BDabek1/sMouthguard/fab/sMouthguard01_BOM_JLC.csv

Comment | Designator | Footprint | LCSC Part #
100nF 6.3V X5R | C2,C3,C5,C6,C9,C11,C12,C15 | 0201 | C160831
2.2uF 6.3V X5R CL03A225MQ3CRNC | C8,C18 | 0201 | C77762
4.7uF 6.3V X5R GRM035R60J475ME15D | C10,C13 | 0201
1uF 10V X5R | C17,C23,C24 | 0201 | C76935
10pF 50V C0G | C7,C19 | 0201 | C76921
2.2uF 6.3V X5R | C4 | 0402 | C12530
1uF 25V X5R | C16 | 0402 | C52923
1pF 50V C0G +/-0.1pF | C26 | 0402 | C76898
68nF 50V X7R | C14 | 0603 | C31658
10uH MLZ1608N100LT000 | L1 | 0603 | C194437
3.9nH LQG15HS3N9S02D | L3 | 0402 | C77109
2.7nH LQG15HS2N7S02D | L4 | 0402 | C77108
10k 1% | R2 | 0402 | C25744
2.2k 1% | R5,R7,R8 | 0402 | C25879
BLM18HE152SN1D | FL1 | 0603 | C82155
CC2640R2FRSMR | U4 | VQFN-32_4x4mm | C133236
LTC4124EV#TRPBF | U2 | LQFN-12_2x2mm | C687345
TPS7A0233PDQNR | U5 | X2SON-4_1x1mm | C2860046
LSM6DSV320XTR | U1 | LGA-14_2.5x3mm
2450BM14G0011T | Z2 | 0603-6pad | C2917723
2450AT18A100E (=2450AT18A0100001E) | E2 | 3216 | C89334
FC-135R 32.7680KA-AG0 | Y1 | 3215
TSX-3225 24.0000MF15X-AC3 | Y2 | 3225-4pad
