BDabek1/sMouthguard/hardware/sMouthguard01.kicad_pcb

## KiCad design hardware/sMouthguard01.kicad_pcb (2026-11-03)

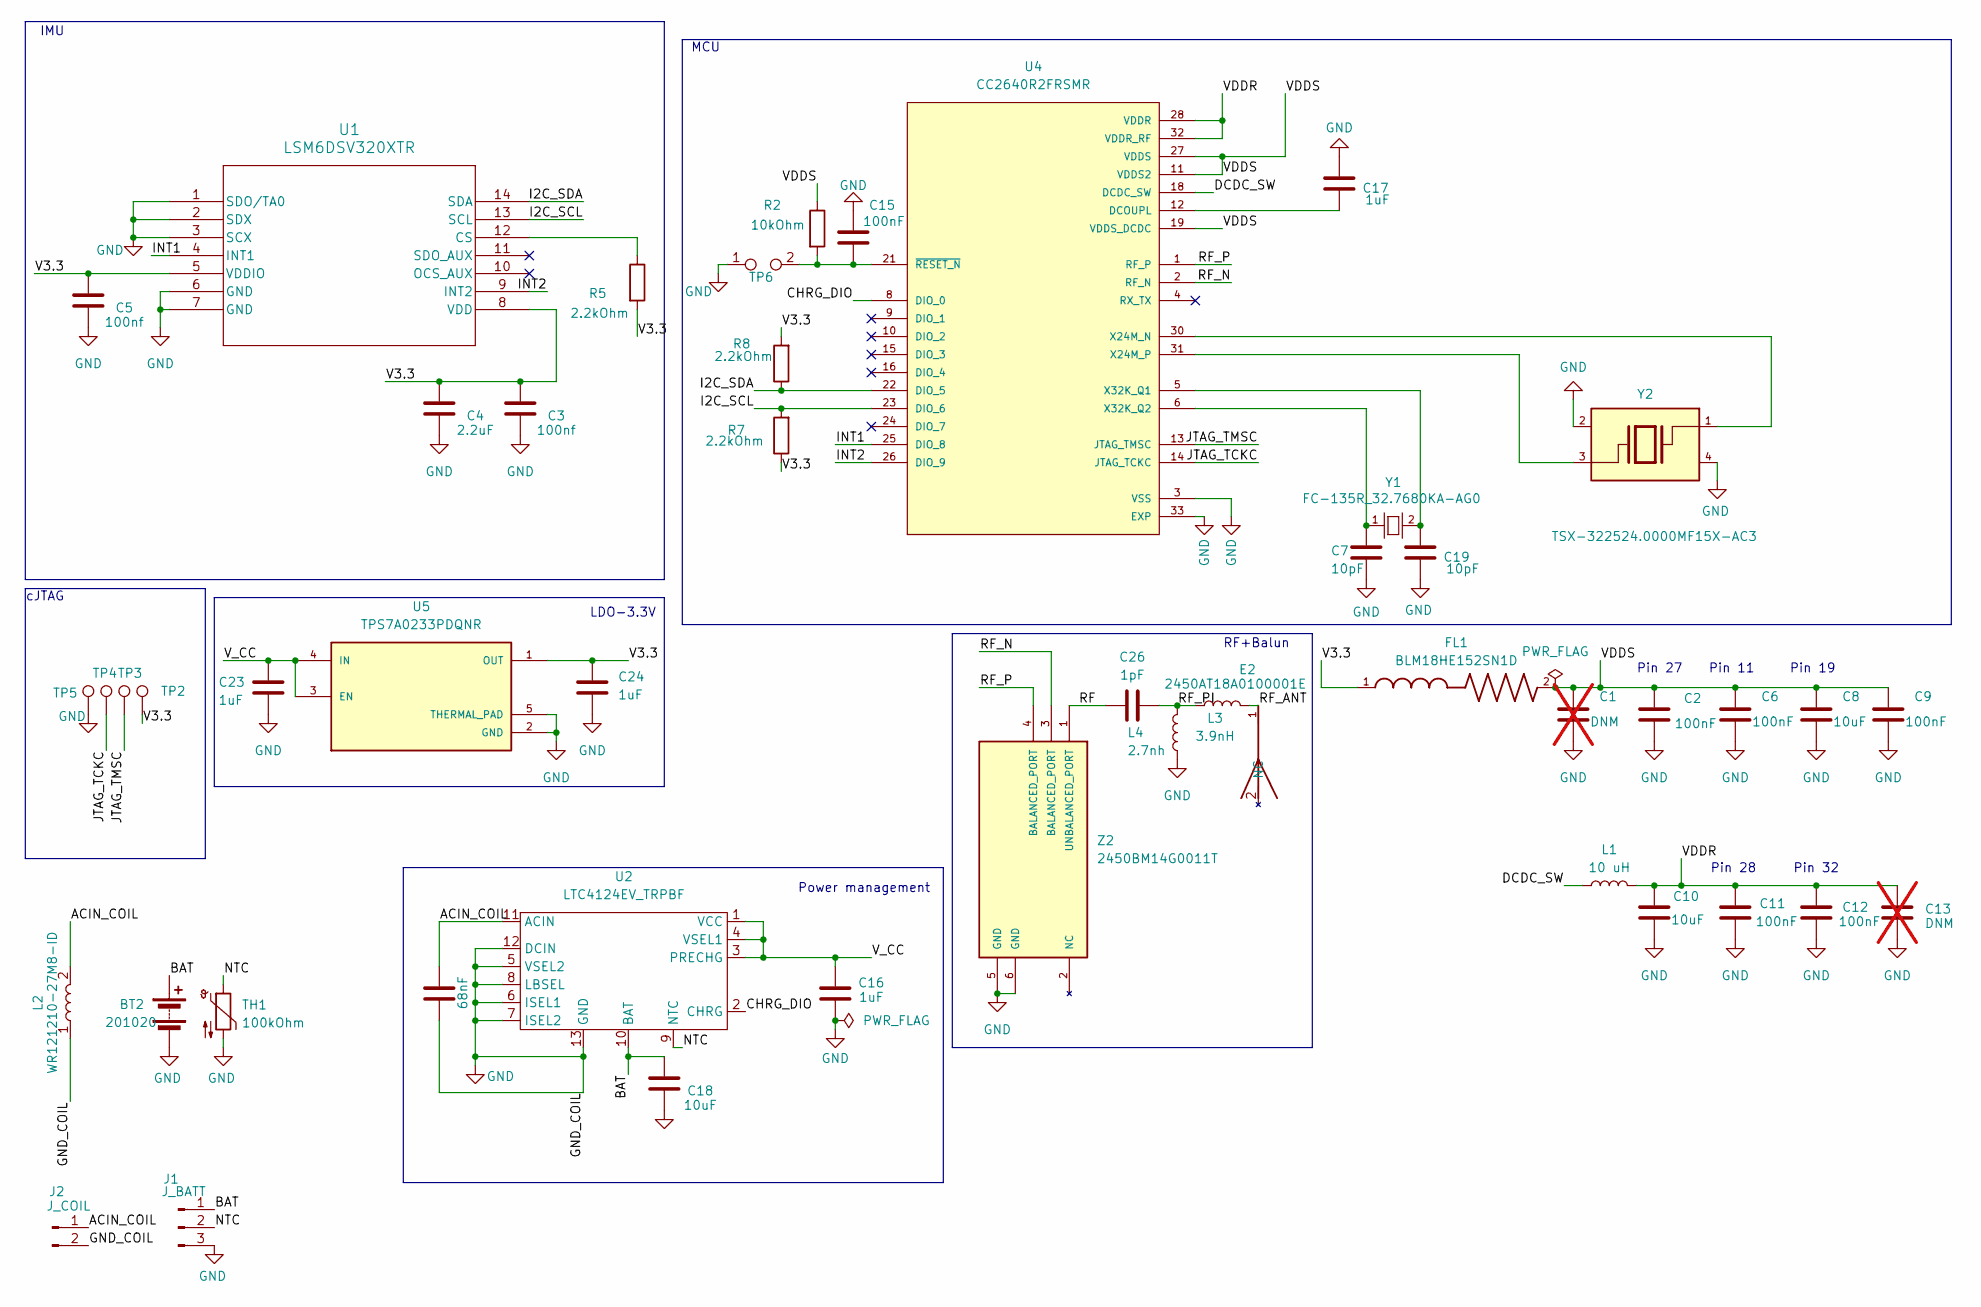
[picture p1: schematic sMouthguard01.kicad_sch, sMouthguard BLE IMU Sensing Device]

Parts:
BT2: 201020
C1, C13: DNM; C_0201_0603Metric; not fitted
C2, C6, C9, C11, C12, C15: 100nF; C_0201_0603Metric
C3, C5: 100nf; C_0201_0603Metric
C4: 2.2uF; C_0402_1005Metric
C7, C19: 10pF; C_0201_0603Metric
C8, C10, C18: 10uF; C_0201_0603Metric
C14: 68nF; C_0603_1608Metric
C16: 1uF; C_0402_1005Metric
C17, C23, C24: 1uF; C_0201_0603Metric
C26: 1pF; C_0402_1005Metric
E2: 2450AT18A0100001E; XCVR_2450AT18A0100001E; PARTREV 4.0
FL1: BLM18HE152SN1D; BEADC1608X95N
J1: J_BATT; SolderWire-0.1sqmm_1x03_P3.6mm_D0.4mm_OD1mm
J2: J_COIL; SolderWire-0.1sqmm_1x02_P3.6mm_D0.4mm_OD1mm
L1: 10 uH; L_0603_1608Metric
L2: WR121210-27M8-ID
L3: 3.9nH; L_0402_1005Metric
L4: 2.7nh; L_0402_1005Metric
R2: 10kOhm; R_0402_1005Metric
R5, R7, R8: 2.2kOhm; R_0402_1005Metric
TH1: 100kOhm; R_0402_1005Metric
TP2: 3.3V; TestPoint_Pad_D1.0mm
TP3: JTAG_TMSC; TestPoint_Pad_D1.0mm
TP4: JTAG_TCKC; TestPoint_Pad_D1.0mm
TP5: GND; TestPoint_Pad_D1.0mm
TP6: TP; SolderJumper-2_P1.3mm_Open_Pad1.0x1.5mm
U1: LSM6DSV320XTR; LGA-14L_2p5X3X0p83_STM
U2: LTC4124EV_TRPBF; QFN50P200X200X83-13N
U4: CC2640R2FRSMR; QFN40P400X400X100-33N
U5: TPS7A0233PDQNR; IC_TPS7A0233PDQNR; PARTREV C
Y1: FC-135R_32.7680KA-AG0; Crystal_SMD_3215-2Pin_3.2x1.5mm
Y2: TSX-322524.0000MF15X-AC3; OSCCC320X250X60; PARTREV N/A
Z2: 2450BM14G0011T; BALUN_2450BM14G0011T; PARTREV 2.0

Connections:
/ACIN_COIL: C14.1, J2.1, L2.2, U2.11 (ACIN)
/BAT: BT2.1 (+), C18.1, J1.1, U2.10 (BAT)
/CHRG_DIO: U2.2 (CHRG), U4.8 (DIO_0)
/DCDC_SW: L1.1, U4.18 (DCDC_SW)
/I2C_SCL: R7.2, U1.13 (SCL), U4.23 (DIO_6)
/I2C_SDA: R8.1, U1.14 (SDA), U4.22 (DIO_5)
/INT1: U1.4 (INT1), U4.25 (DIO_8)
/INT2: U1.9 (INT2), U4.26 (DIO_9)
/JTAG_TCKC: TP4.1, U4.14 (JTAG_TCKC)
/JTAG_TMSC: TP3.1, U4.13 (JTAG_TMSC)
/NTC: J1.2, TH1.1, U2.9 (NTC)
/RF: C26.1, Z2.1 (UNBALANCED_PORT)
/RF_ANT: E2.1, L3.2
/RF_N: U4.2 (RF_N), Z2.3 (BALANCED_PORT)
/RF_P: U4.1 (RF_P), Z2.4 (BALANCED_PORT)
/RF_PI: C26.2, L3.1, L4.2
/V3.3: C3.1, C4.1, C5.1, C24.2, FL1.1, R5.2, R7.1, R8.2, TP2.1, U1.5 (VDDIO), U1.8 (VDD), U5.1 (OUT)
/VDDR: C10.1, C11.1, C12.1, C13.1, L1.2, U4.28 (VDDR), U4.32 (VDDR_RF)
/VDDS: C1.1, C2.1, C6.1, C8.1, C9.1, FL1.2, R2.1, U4.11 (VDDS2), U4.19 (VDDS_DCDC), U4.27 (VDDS)
/V_CC: C16.1, C23.2, U2.1 (VCC), U2.3 (PRECHG), U2.4 (VSEL1), U5.3 (EN), U5.4 (IN)
GND: BT2.2 (-), C1.2, C2.2, C3.2, C4.2, C5.2, C6.2, C7.2, C8.2, C9.2, C10.2, C11.2, C12.2, C13.2, C14.2, C15.1, C16.2, C17.1, C18.2, C19.2, C23.1, C24.1, J1.3, J2.2, L2.1, L4.1, TH1.2, TP5.1, TP6.1, U1.1 (SDO/TA0), U1.2 (SDX), U1.3 (SCX), U1.6 (GND), U1.7 (GND), U2.5 (VSEL2), U2.6 (ISEL1), U2.7 (ISEL2), U2.8 (LBSEL), U2.12 (DCIN), U2.13 (GND), U4.3 (VSS), U4.7 (VSS), U4.17 (VSS), U4.20 (VSS), U4.29 (VSS), U4.33 (EXP), U4.33_1 (EXP), U4.33_2 (EXP), U4.33_3 (EXP), U4.33_4 (EXP), U4.33_5 (EXP), U5.2 (GND), U5.5 (THERMAL_PAD), Y2.2, Y2.4, Z2.5 (GND), Z2.6 (GND)
unnamed: R5.1, U1.12 (CS)
unnamed: C17.2, U4.12 (DCOUPL)
unnamed: U4.30 (X24M_N), Y2.1
unnamed: U4.31 (X24M_P), Y2.3
unnamed: C19.1, U4.5 (X32K_Q1), Y1.2
unnamed: C7.1, U4.6 (X32K_Q2), Y1.1
unnamed: C15.2, R2.2, TP6.2, U4.21 (~RESET_N)

Notes on the sheet:
RF+Balun
Power management
Pin 19
LDO-3.3V
IMU
Pin 32
Pin 27
Pin 28
MCU
cJTAG
Pin 11

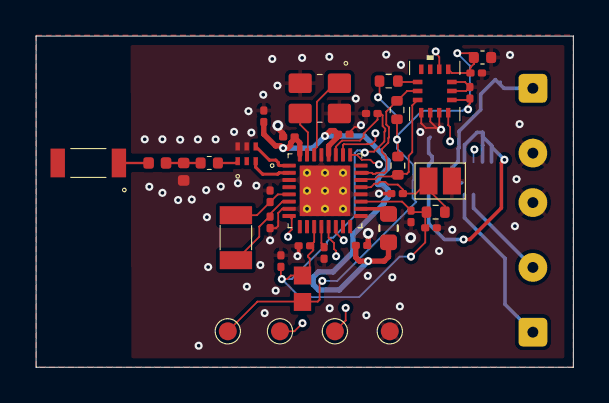
[picture p2: board sMouthguard01.kicad_pcb from above]

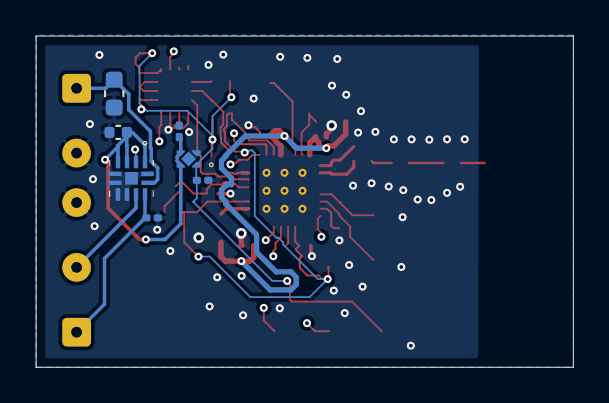
[picture p3: board sMouthguard01.kicad_pcb from below]

Board: 4 copper layers, 29.9 x 18.4 mm, 45 parts (9 on the bottom side), 28 nets.
