BDabek1/sMouthguard/(commit log)

2026-11-03 Hardware Rev 2.0: Includes PCB, schematic and fabrication files
    [sMouthguard01-B_Cu.gbr, sMouthguard01-B_Mask.gbr, sMouthguard01-B_Paste.gbr, sMouthguard01-B_Silkscreen.gbr, sMouthguard01-Edge_Cuts.gbr, sMouthguard01-F_Cu.gbr, sMouthguard01-F_Mask.gbr, sMouthguard01-F_Paste.gbr]
2026-11-03 Sync schematic values to BOM
    [sMouthguard01.kicad_sch]
